ceyhunkocc/EE463-TermProject/Ceyhun/pcb screenshots/overview_new.JPG

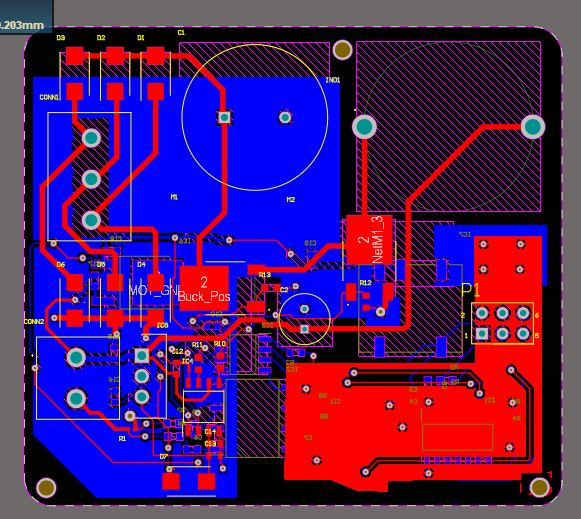
Ceyhun/pcb screenshots/overview_new.JPG
