ceyhunkocc/EE463-TermProject/Ceyhun/pcb screenshots/pcb_line_validate.JPG

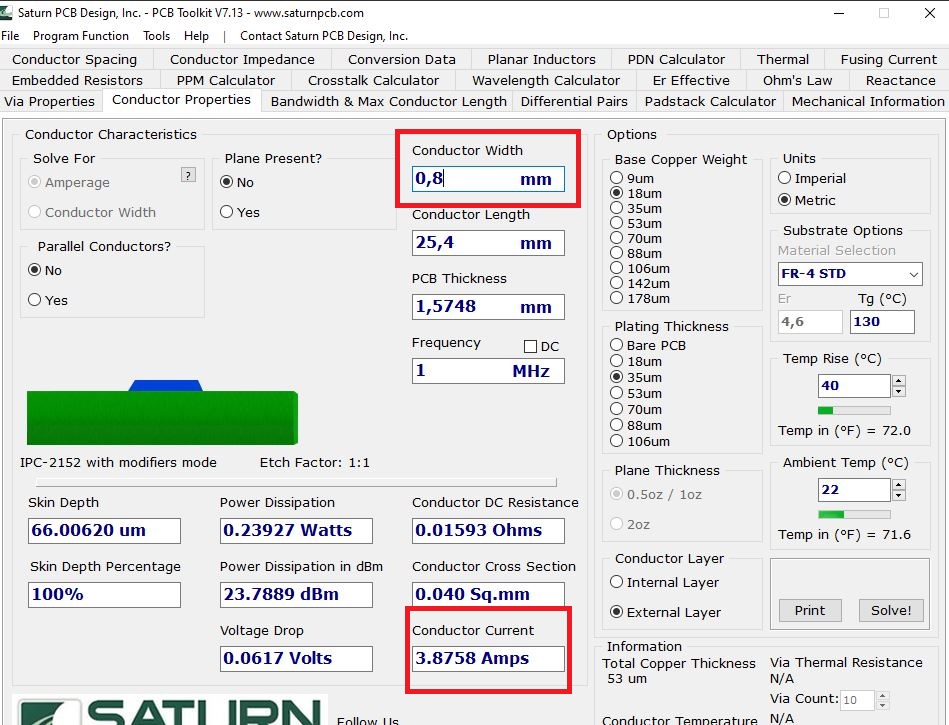
Ceyhun/pcb screenshots/pcb_line_validate.JPG
