ceyhunkocc/EE463-TermProject/README.md

# EE463-TermProject
This repository is used for term project works by Ceyhun KOÇ, Görkem GÜLLETUTAN and Defnenur KORKMAZ.
