ceyhunkocc/EE463-TermProject/Defne/simulation waveforms.docx

İnput output voltage rectifier


Phase a input and output current


Diode voltage and current


Buck mosfet voltage current


Buck output voltage current

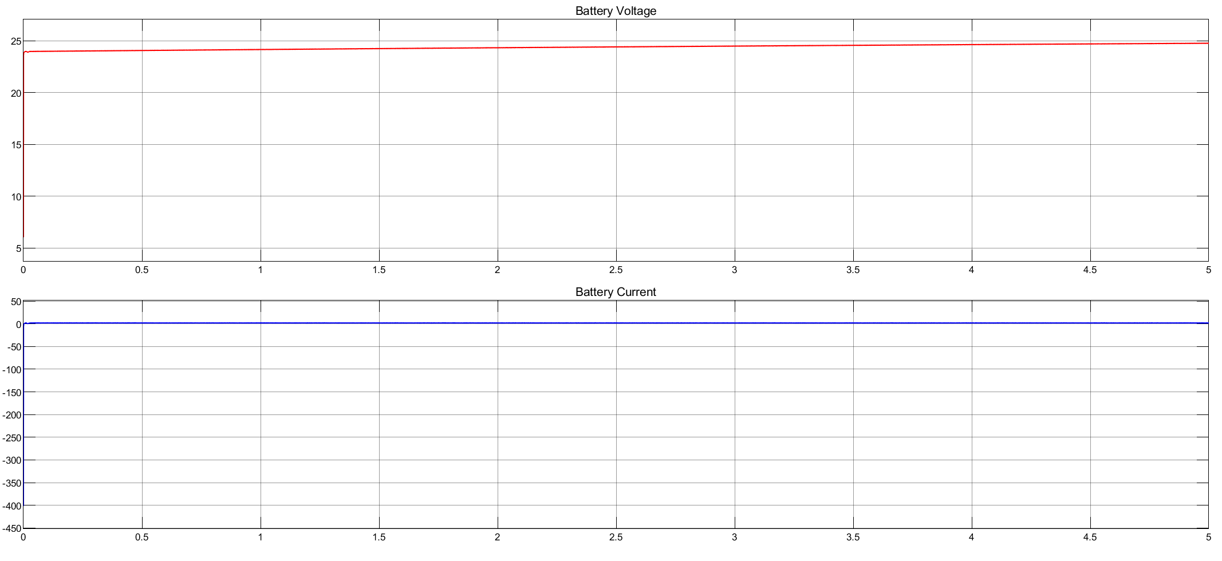
[picture p63: figure]
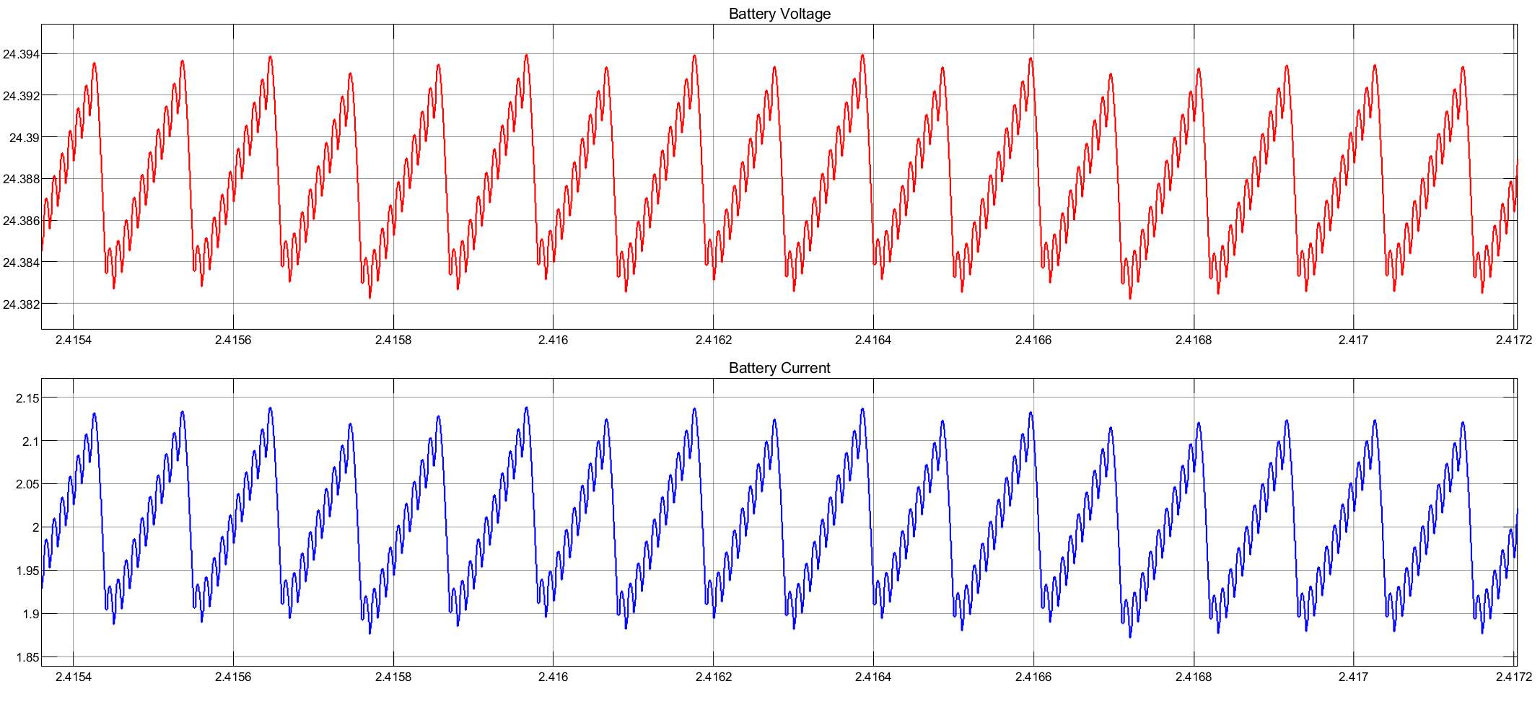
[picture p64: figure]

Battery current and voltage
