ceyhunkocc/EE463-TermProject/Ceyhun/pcb screenshots/Yeni Microsoft PowerPoint Presentation.pptx

Rectifier Capacitor

Buck Inductor


High Side Diodes

Motor Connector

Low Side Diodes

Battery Connector

Shunt Resistor

MOSFET High

Buck Capacitor

MOSFET Low

## Slide 2

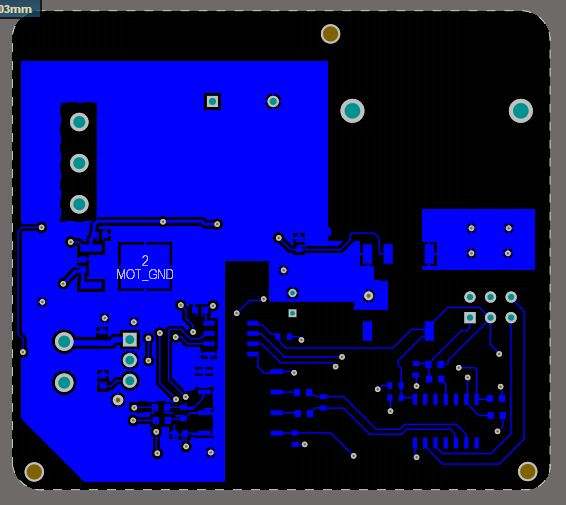
[picture p65: figure]

MOT_GND Plane

ISOLATION BOUNDARY

ISO_GND Plane

Digital Isolator

Controller Connector

Microcontroller

Isolated Op-amp

## Slide 3

24V/3V3 Conversion

24V/12V Conversion

3V3 Isolated Conversion

## Slide 4

Fiducial

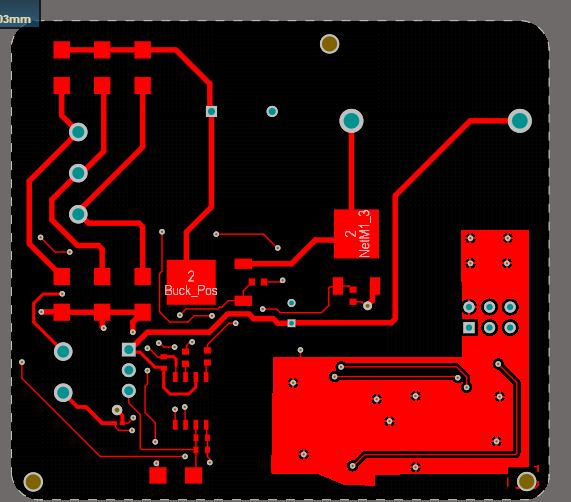
[picture p66: figure]

Gate Driver

Fiducial

Bootstrap Diode

Fiducial

## Slide 5

Rectifier Capacitor

Buck Inductor

High Side Diodes


Motor Connector

MOSFET Low w/heatsink

Low Side Diodes

Controller Connector

Battery Connector

Gate Driver

MOSFET High w/heatsink

24V/12V Conversion

Bootstrap Diode

Buck Capacitor

## Slide 6


24V/3V3 Conversion

Digital Isolator

Isolated Op-amp

3V3 Isolated Conversion

Microcontroller
