ceyhunkocc/EE463-TermProject/Defne/Inductor design/E.docx

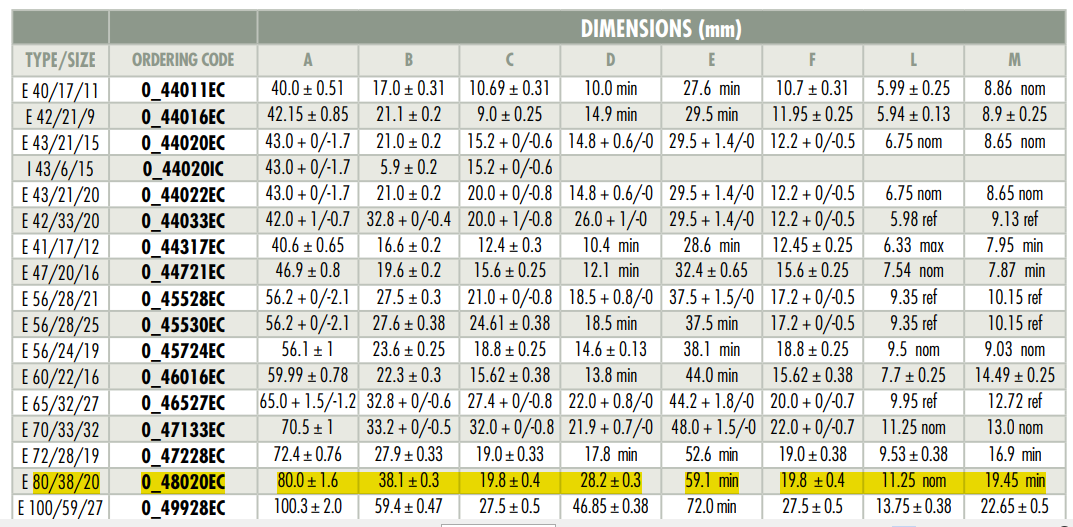
[picture p86: figure]
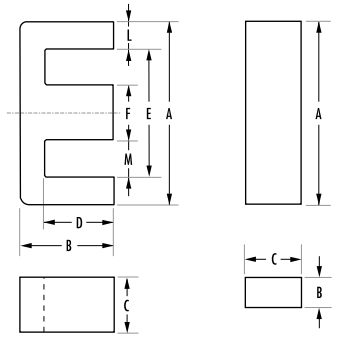
[picture p87: figure]

E, I cores

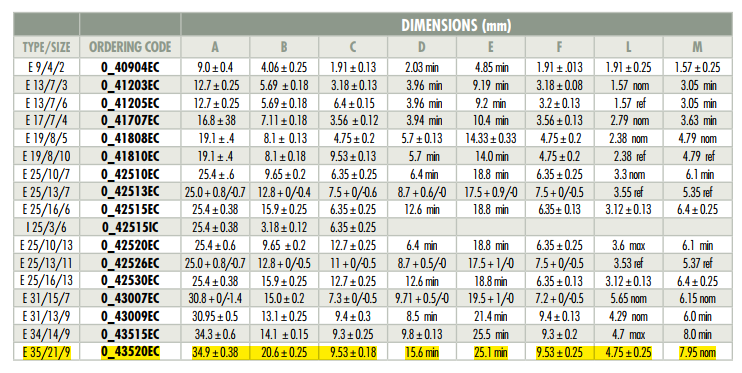
[picture p88: figure]
