ceyhunkocc/EE463-TermProject/Defne/Inductor design/1608928195178.pdf

Bobin Tasarımı

Tablodan Uygun Nüvenin Seçilmesi

Anahtarlamalı güç kaynaklarında kullanılan bobinler ve flyback dönüştürücülerde kullanılan transformatörler manyetik enerji depo eder. Bu enerji ferit nüvede büyük ölçüde hava aralığında depo edilir. Depo edilen enerji aşağıdaki şekilde hesaplanır.

Uygun bir nüve seçebilmek için;

- Nüvenin manyetik enerji depo etme kapasitesi hesaplanan ½ ·L I

2
max değerinden büyük
olmalıdır.
- Nüve boyutu mümkün olduğu kadar küçük olmalıdır.

Bobin için uygun bir nüvenin seçilmesinde kullanılacak olan tablo 11 sütundan oluşmaktadır. Flyback transformatörü için olan tabloda ise 12 sütun mevcuttur.

İlk dört sütunda nüve kodu ve üreticisi ile ilgili bilgiler verilmektedir.

1. Nüvenin kodu
2. Nüvenin türü
3. Karakteristik değerleri, hava aralığı, sipariş kodu v.b.
4. Üretici

5-8. sütunlarda katalog bilgileri verilmiştir. Bu bilgiler hesaplamalarda kullanılır.

5. AL/nH: Belirli bir L değeri için sarım sayısının ne olması gerektiği bu parametre kullanılarak bulunur.
6. Ae/mm²
: Nüvenin efektif kesiti.
7. le/mm: Nüvenin efektif uzunluğu
8. Amin/mm²
: Maksimum manyetik alan yoğunluğunun hesaplanması için kullanılan minimum kesit değeri

9-12. sütunlarda verilen bilgiler hesaplanarak elde edilir.

9. Wmax/mWs: Nüvenin manyetik enerji depo etme kapasitesi maksimum 0.3 T.
10. Bmax/mT: Nüvedeki maksimum akı yoğunluğu. Giriş gerilimi, nominal yük akımı ve minimum kesit Amin kullanılarak hesaplanan maksimum akı yoğunluğu nüve seçiminde dikkate alınır. Bmax değeri L veya ΔIL ‘ye bağlı olarak değişir.
11. N1 : L endüktansı için gerekli olan sarım sayısı.
12. N2 : Flyback dönüştürücüde sekonder sarım sayısı. N1/N2 oranı azalırsa transistörün Vds_max gerilimi azalır.

İyi seçilmiş bir nüvenin Wmax manyetik enerji depolama kapasitesi gerekli değerden biraz fazladır. Nüve mümkün olan en küçük nüvedir. Maksimum akı yoğunluğu doyma noktası olan 0.3T değerine yakındır.

Tel çapı akım yoğunluğu 3A/mm²
olacak şekilde seçilir.

Transformatör ve Bobin Hesabı

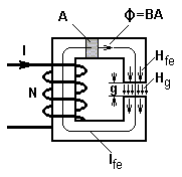
[picture p89: figure]

Ferit nüvede depo edilen manyetik enerjinin bir kısmı nüvede bir kısmı ise hava aralığında depo edilir. Nüvenin fiziksel boyutu depo edilen enerji ile orantılıdır.

Depo edilen manyetik enerji aşağıki eşitlikle verilir.

Manyetik akı yoğunluğu B sürekli olup hava aralığında ve nüve içinde aynıdır.

B ≈ BFe ≈ Bg

Manyetik alan kuvveti H ise sürekli değildir. Hava aralığındaki manyetik alan kuvveti ferit nüve içindeki kuvvetin μr katıdır.

B = μ0μr ·H
IFe = lFe ·A
Vg = g ·A:

g .A

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
Ferit malzemede μr değeri 1000...4000 arasındadır. Effektif manyetik nüve uzunluğu enerji hesabına lFe / μr oranı ile katılır. Normal bir nüvede manyetik enerji büyük ölçüde hava aralığında depo edilir. Bunun sonucu olarak bobin hava aralıklı nüve kullanılarak yapılır. Bmax = 0.3T’yı geçmeyecek şekilde yeterli enerji depo edebilmesi için ne kadar bir hava aralığının bırakılması gerektiği hesaplanır.

Hava aralığı arttıkça manyetik enerji depo etme kapasitesi artar.
Ferit nüve üreticileri (lFe/μr+g)·A) terimini kapsayan değerler verir. Bu değerler,

- Nüvenin efektif manyetik kesiti Ae,
- Nüvenin efektif manyetik yolu le
- Nüvenin efektif permeabilitesi μe.

Bu değerler bağlı olarak

e

e
e
r
Fe | l
g .A | A .

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
μe değeri manyetik iletkenlik AL kullanılarak hesaplanır.

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
e L A

l
A .

Manyetik enerji depo etme kapasitesi aşağıdaki şekilde hesaplanır.

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
B 0.3T

Tabloda verilen Ae, le, AL ve Amin değerleri kullanılarak manyetik enerji depo etme kapasitesi hesaplanır. Bu sonuca uygun olan nüveler arasından seçim yapılır. Seçilen nüvenin Wmax değeri W = ½ L I

2
değerinden büyük olmalıdır. Nüve hacmi Ae·le ile hesaplanır.

N1 sarım sayısı manyetik iletkenlik AL kullanılarak hesaplanır.

Flyback dönüştürücüde sekonder sarım sayısı dönüştürme oranı ve N1 kullanılarak aşağıdaki şekilde hesaplanır.

Tel Çapının Hesaplanması

S akım yoğunluğu transformatörün termik direncine bağlı olarak 2 ile 5 A/mm² arasında
seçilir. Tel kesiti ve yarıçapı aşağıdaki şekilde hesaplanır.
