ceyhunkocc/EE463-TermProject/Gorkem/powerlosses.thermalanalysis.pdf

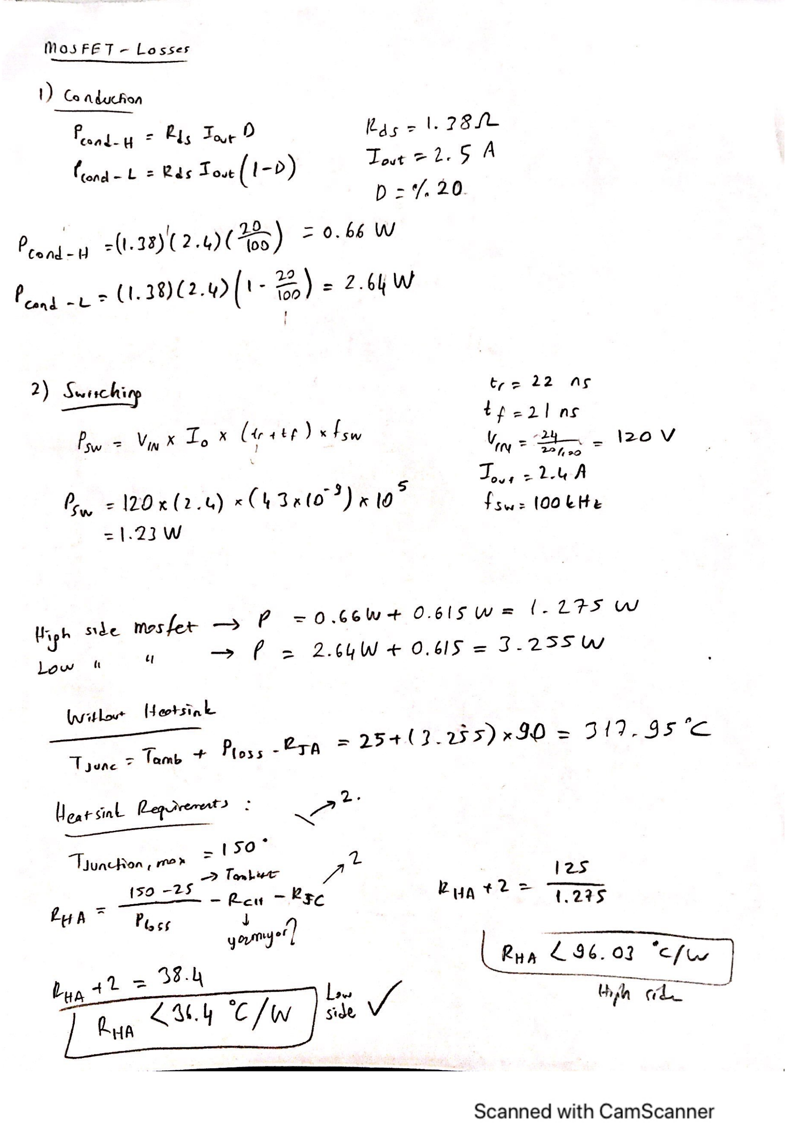
[picture p90: page 1]
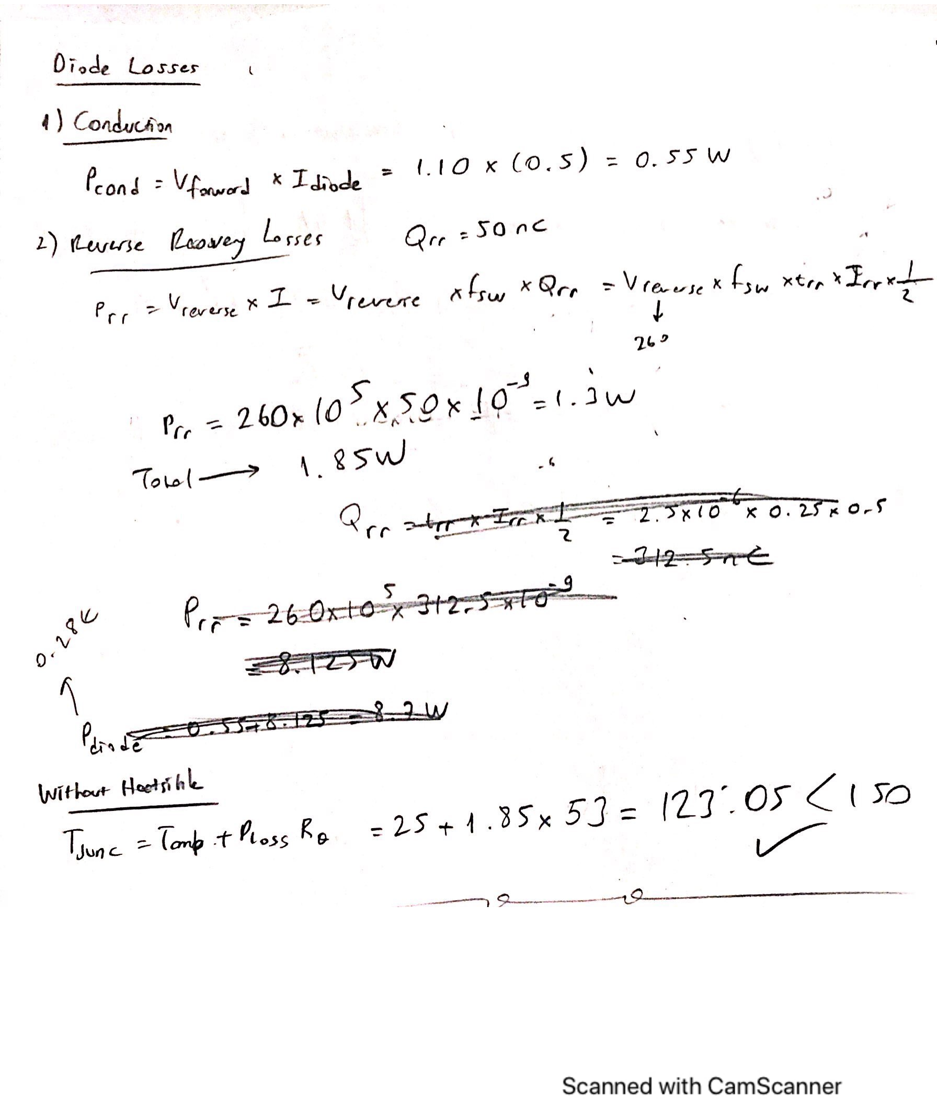
[picture p91: page 2]
