ceyhunkocc/EE463-TermProject/Defne/Inductor design/1608928195184.xls

 | http://www.cosmoferrites.com/product/eeindex2.html#
TYPE | DIMENSIONS (mm) |  |  |  |  |  | AL (nH) +30%
 |  |  |  |  |  |  | -20%
 | A | B | C | D | E | F |  | CF 196 (http://www.cosmoferrites.com/material_info.html) | CF 138 (http://www.cosmoferrites.com/material_info.html) | CF101 (http://www.cosmoferrites.com/material_info.html) | CF195 (http://www.cosmoferrites.com/material_info.html)
EE10028 | 100.3±2.0 | 73.2±1.40 | 59.5±0.50 | 46.8±0.80 | 27.5±0.50 | 27.6±0.50 |  | 5900 | 6200 | - | -
EE8020 | 80.00 -0.90 | 60.30+0.90 | 38.10+0.33 | 28.53 +0.33 | 19.80 -0.30 | 19.80 -0.30 |  | 4500 | 4700 | -- | --
EE7219 | 72.40 -1.45 | 53.35+1.10 | 27.95+0.15 | 18.05 +0.25 | 19.05 -0.38 | 19.05 -0.38 |  | 6200 | 6500 | 8900 | --
EE6527 | 66.50 -2.70 | 44.20+1.80 | 32.50+0.30 | 22.20 +0.70 | 20.00 -0.70 | 27.40 -0.80 |  | 7800 | 8100 | -- | --
EE6513 | 66.50 -2.70 | 44.20+1.80 | 32.50+0.30 | 22.20 +0.70 | 20.00 -0.70 | 13.70 -0.60 |  | 3900 | 4050 | 5400 | --
EE5541 | 55.1±1.1 | 38.1±0.75 | 27.5±0.15 | 18.8±0.4 | 16.85±0.3 | 40.9±0.75 |  | 12200 | 12750 | - | -
EE5525 | 55.00+1.20 | 37.50+1.20 | 27.80-0.60 | 18.50 +0.80 | 17.20 -0.50 | 25.00 -0.60 |  | 7600 | 7950 | -- | --
EE5521 | 55.00+1.20 | 37.50+1.20 | 27.80-0.60 | 18.50 +0.80 | 17.20 -0.50 | 21.00 -0.60 |  | 6200 | 6400 | 8700 | --
EE4732 | 46.85±1.0 | 32.25±0.7 | 19.6±0.2 | 12.2±0.3 | 15.6±0.3 | 31.25±0.3 |  | 11400 | 11900 | 15650 | -
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
EEL1905 | 19.00 +0.30 | 14.00+0.30 | 13.55+0.20 | 11.30 +0.30 | 4.85 +0.25 | 4.85 +0.20 |  | 800 | 850 | 1100 | 1550
EEL1605 | 16.00 +0.30 | 12.10 +0.30 | 12.45 +0.20 | 10.25 +0.20 | 4.00 -0.20 | 4.80 -0.20 |  | 700 | 750 | 950 | 1350
EEL1605B | 16.00 +0.70 | 12.10 +0.30 | 6.95 +0.15 | 5.40 +0.20 | 4.00 -0.20 | 4.80 -0.20 |  | 875 | 900 | 1150 | 1550
