ceyhunkocc/EE463-TermProject/Ceyhun/battery_new.jpg

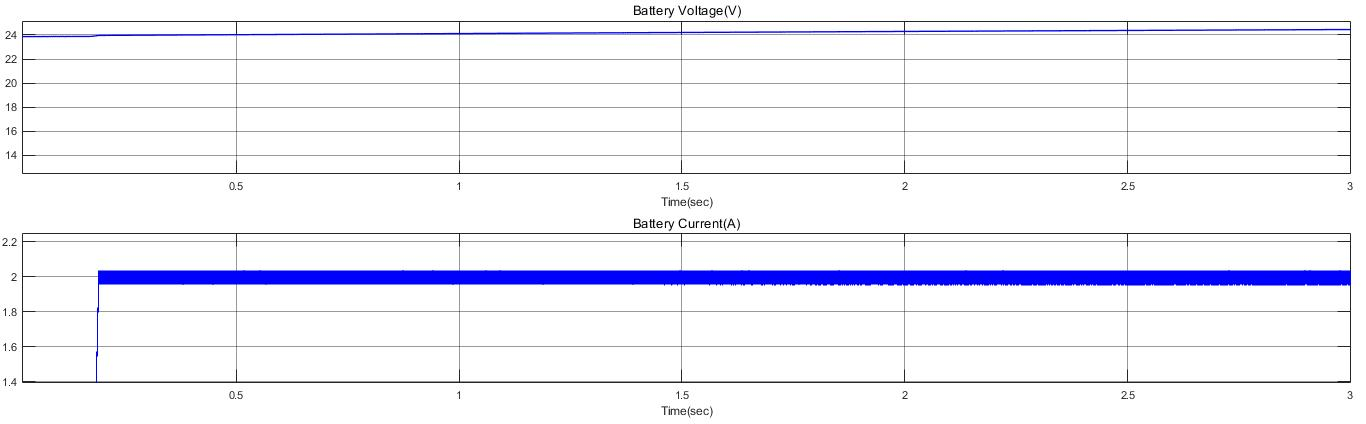
Ceyhun/battery_new.jpg
