ceyhunkocc/EE463-TermProject/Ceyhun/battery_new_detailled.jpg

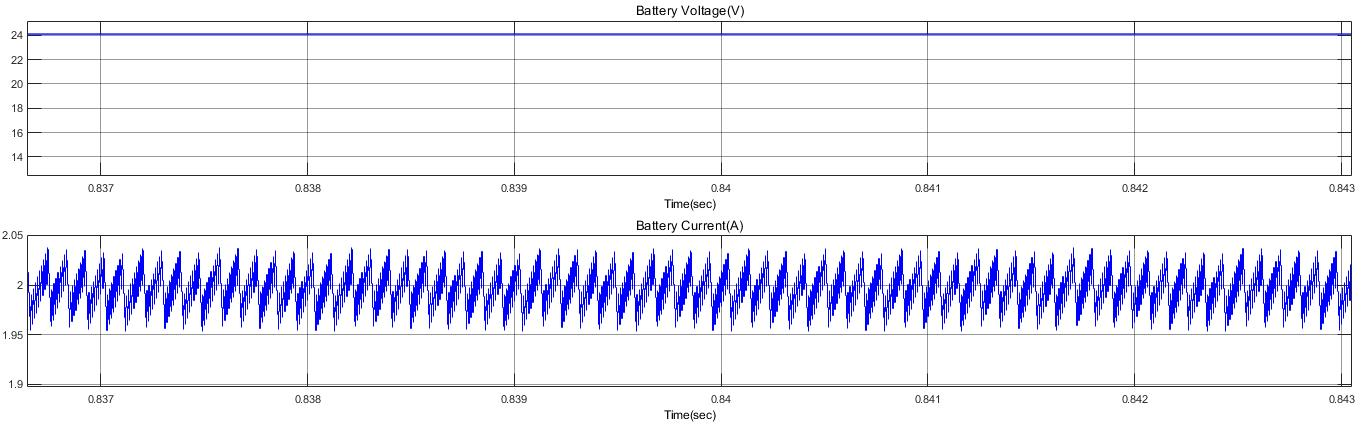
Ceyhun/battery_new_detailled.jpg
