ceyhunkocc/EE463-TermProject/Ceyhun/Ideal Simulations/battery output.jpg

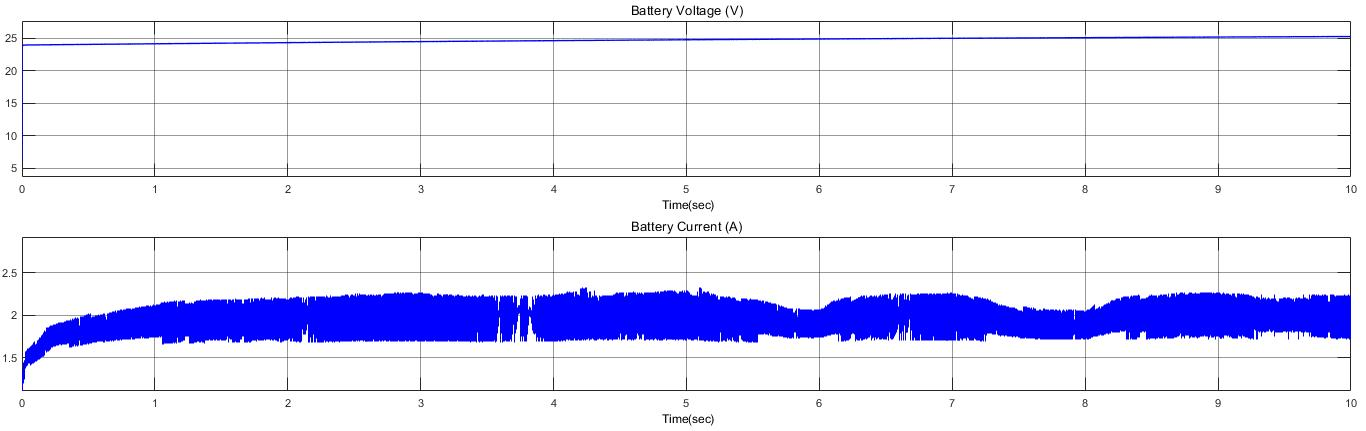
Ceyhun/Ideal Simulations/battery output.jpg
