ceyhunkocc/EE463-TermProject/Ceyhun/Ideal Simulations/duty cycle.jpg

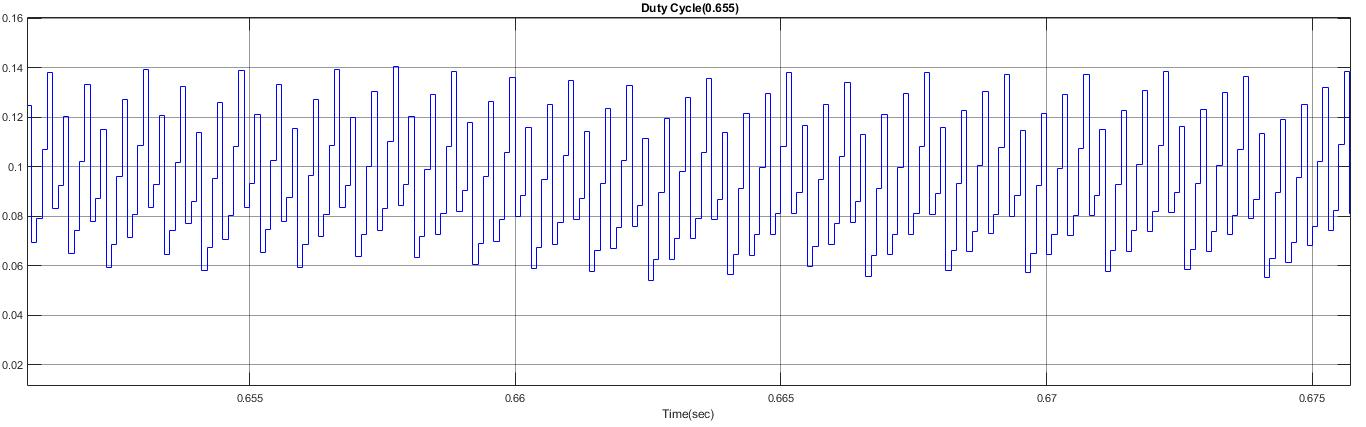
Ceyhun/Ideal Simulations/duty cycle.jpg
