ceyhunkocc/EE463-TermProject/Ceyhun/Ideal Simulations/Input l-l.jpg

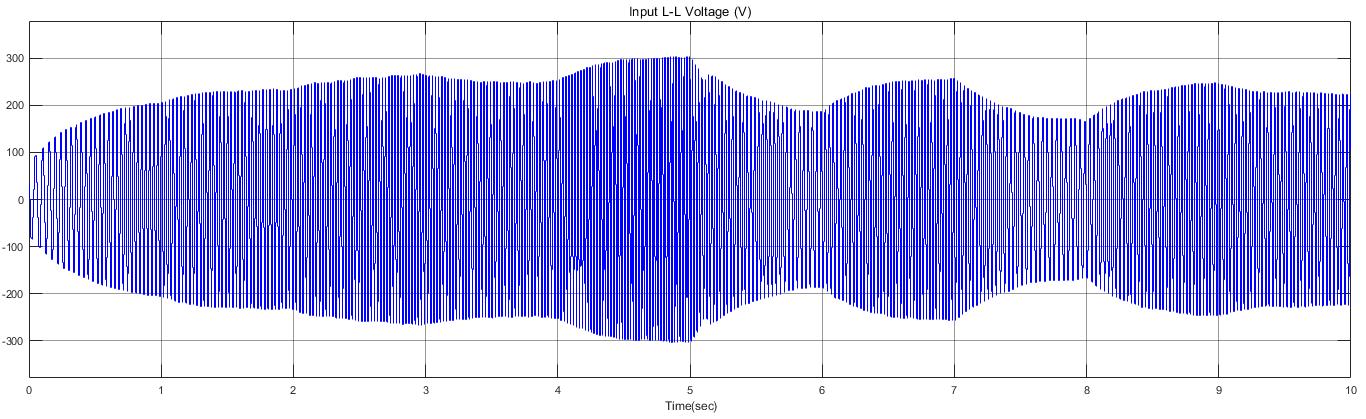
Ceyhun/Ideal Simulations/Input l-l.jpg
