ceyhunkocc/EE463-TermProject/Ceyhun/Nonideal Simulations/Battery output.jpg

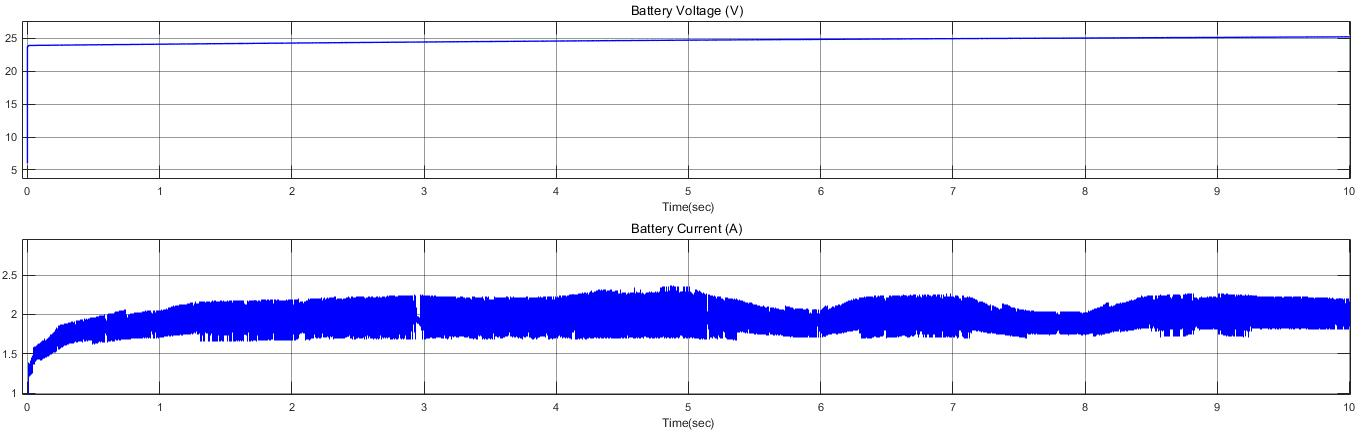
Ceyhun/Nonideal Simulations/Battery output.jpg
