ceyhunkocc/EE463-TermProject/Ceyhun/Nonideal Simulations/duty cycle.jpg

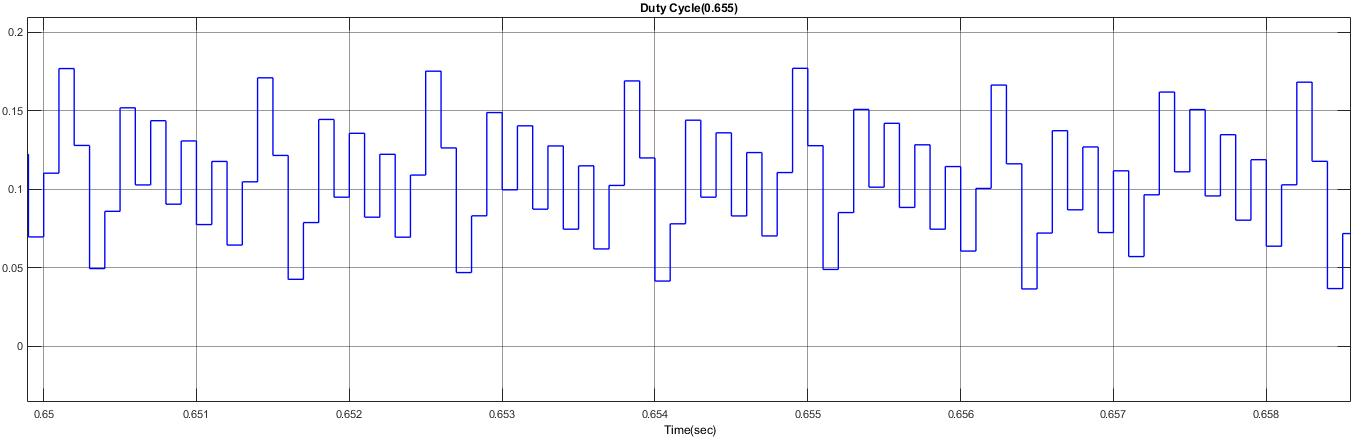
Ceyhun/Nonideal Simulations/duty cycle.jpg
