ceyhunkocc/EE463-TermProject/Ceyhun/Nonideal Simulations/Rectifier Output.jpg

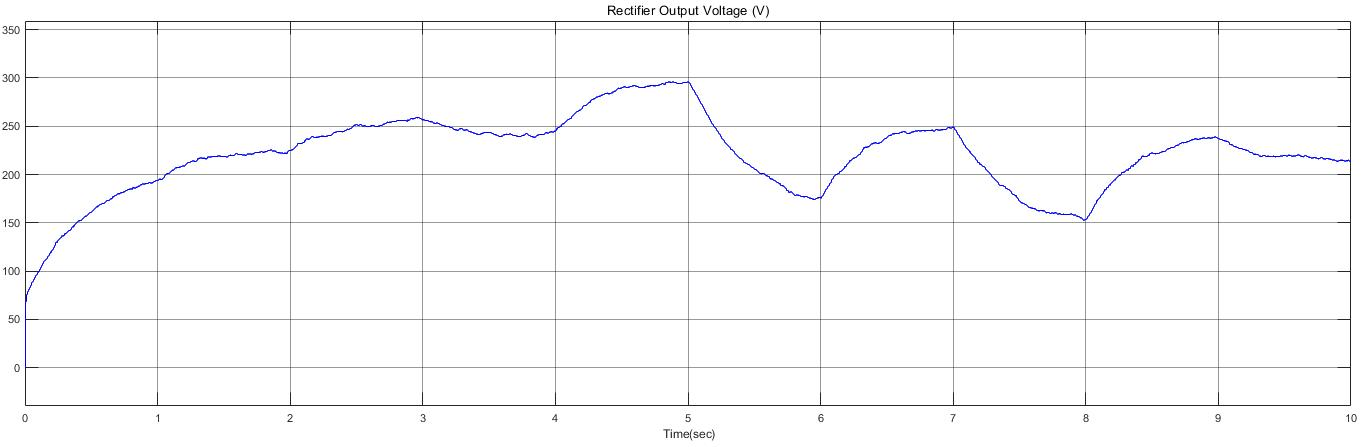
Ceyhun/Nonideal Simulations/Rectifier Output.jpg
