ceyhunkocc/EE463-TermProject/Ceyhun/pcb screenshots/pcb_power_line.JPG

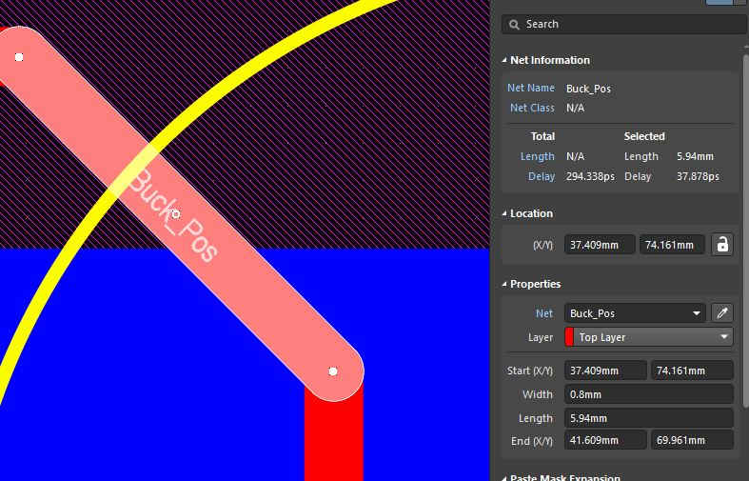
Ceyhun/pcb screenshots/pcb_power_line.JPG
