ceyhunkocc/EE463-TermProject/Ceyhun/pcb screenshots/pcb_power_via.JPG

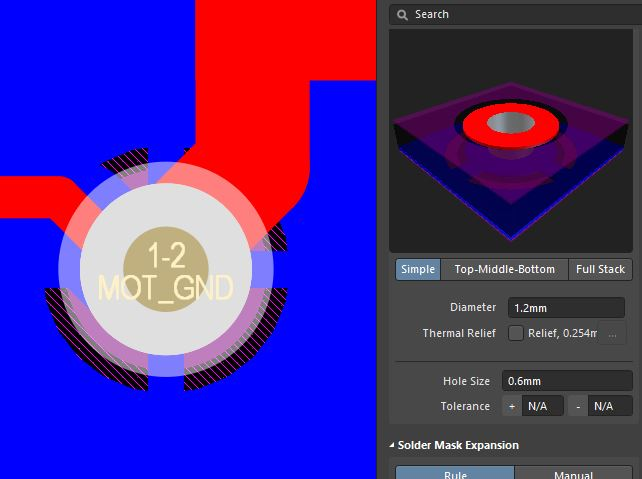
Ceyhun/pcb screenshots/pcb_power_via.JPG
