ceyhunkocc/EE463-TermProject/Ceyhun/pcb screenshots/rect-buck.JPG

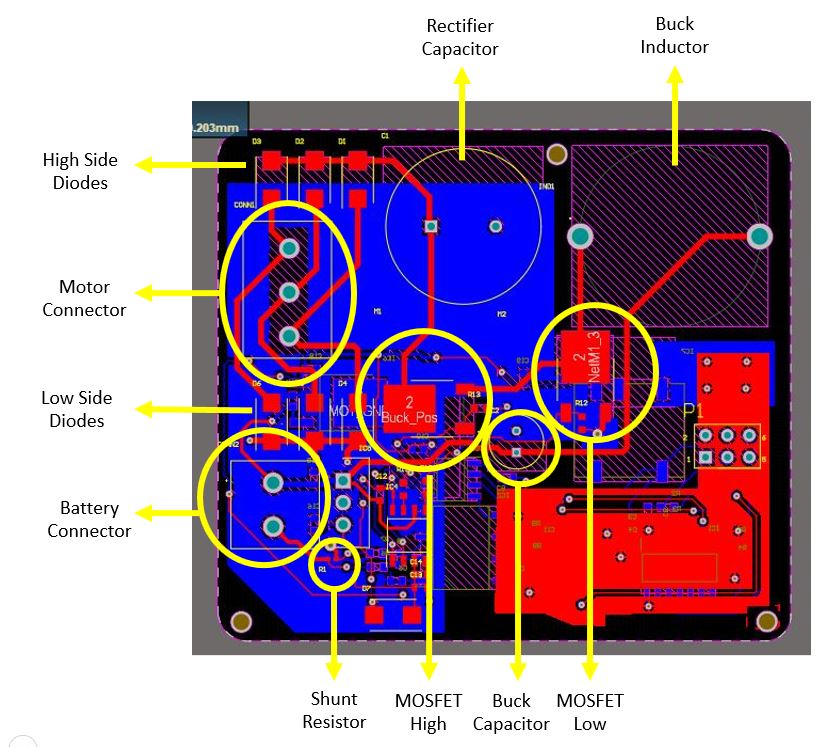
Ceyhun/pcb screenshots/rect-buck.JPG
