ceyhunkocc/EE463-TermProject/Ceyhun/WhatsApp Image 2020-12-22 at 00.09.55.jpeg

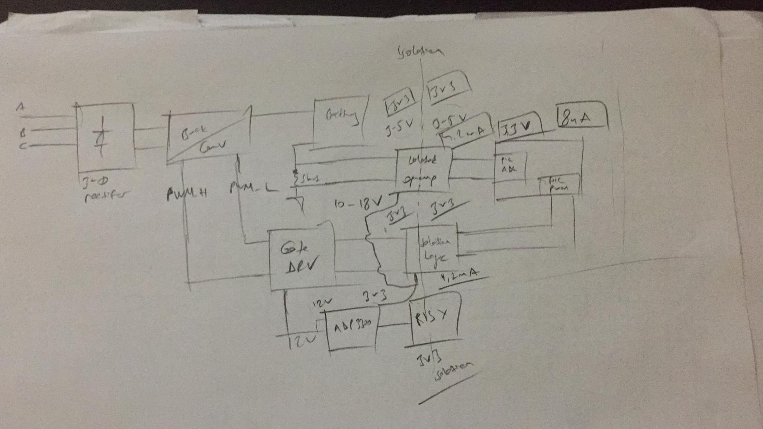
Ceyhun/WhatsApp Image 2020-12-22 at 00.09.55.jpeg
