ceyhunkocc/EE463-TermProject/Defne/Simulation Report/Output waveform.jpeg

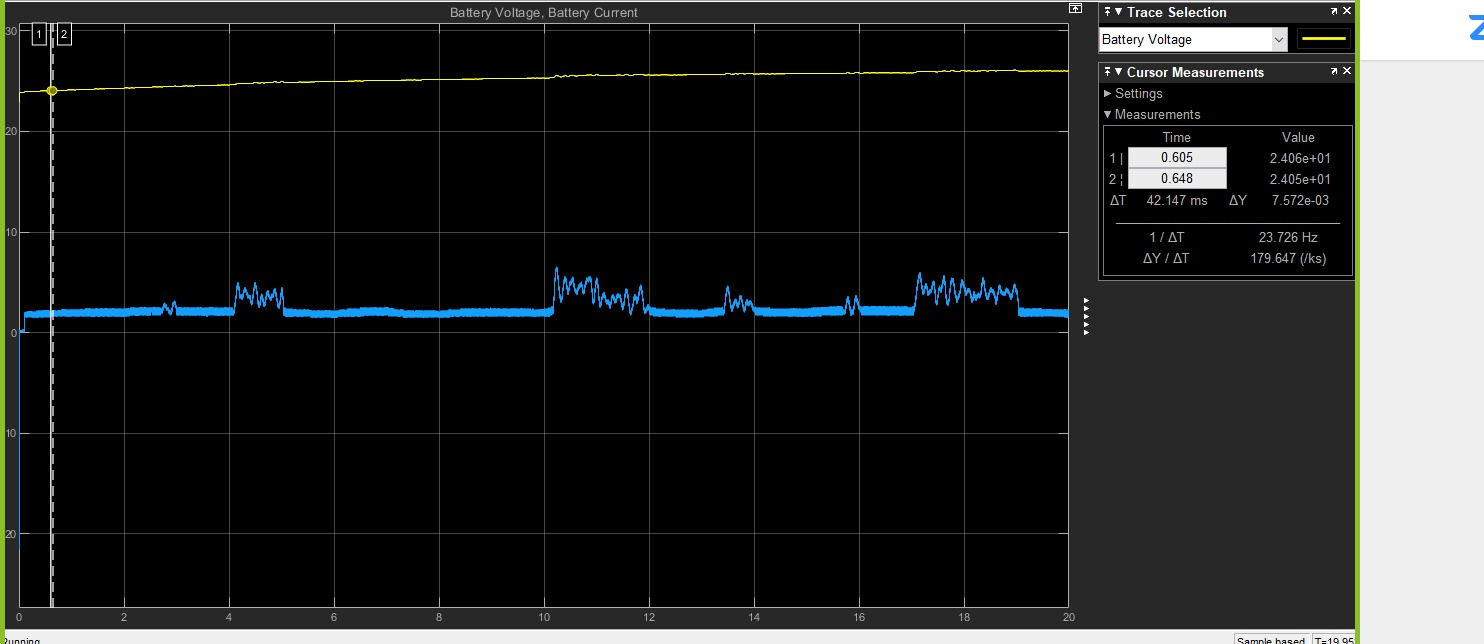
Defne/Simulation Report/Output waveform.jpeg
