ceyhunkocc/EE463-TermProject/Gorkem/Ideal Simulations/rectifier/rec_inputcurrent_thd.jpg

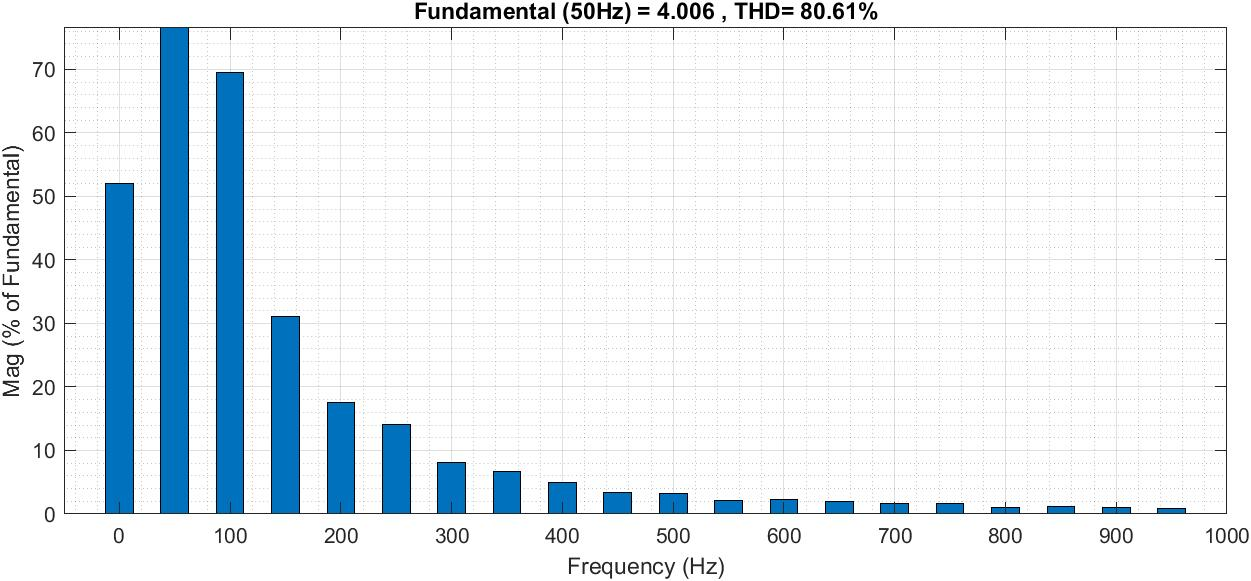
Gorkem/Ideal Simulations/rectifier/rec_inputcurrent_thd.jpg
