ceyhunkocc/EE463-TermProject/Gorkem/Ideal Simulations/rectifier/rec_outputcurrent_thd.jpg

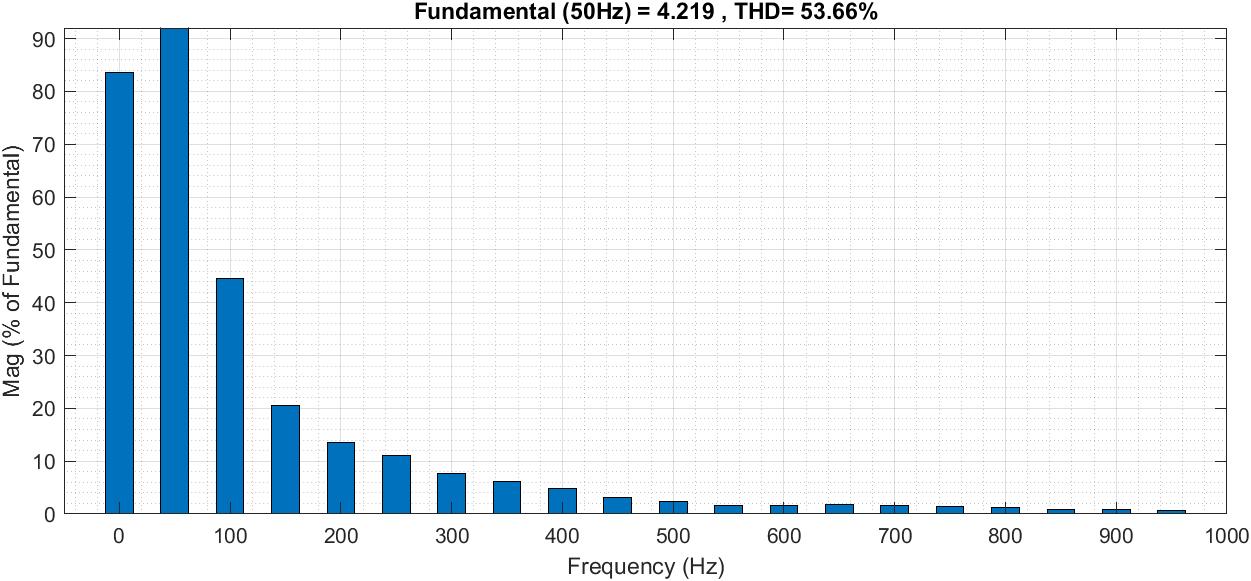
Gorkem/Ideal Simulations/rectifier/rec_outputcurrent_thd.jpg
