ceyhunkocc/EE463-TermProject/Gorkem/Ideal Simulations/rectifier/rectifier_input_output_current.jpg

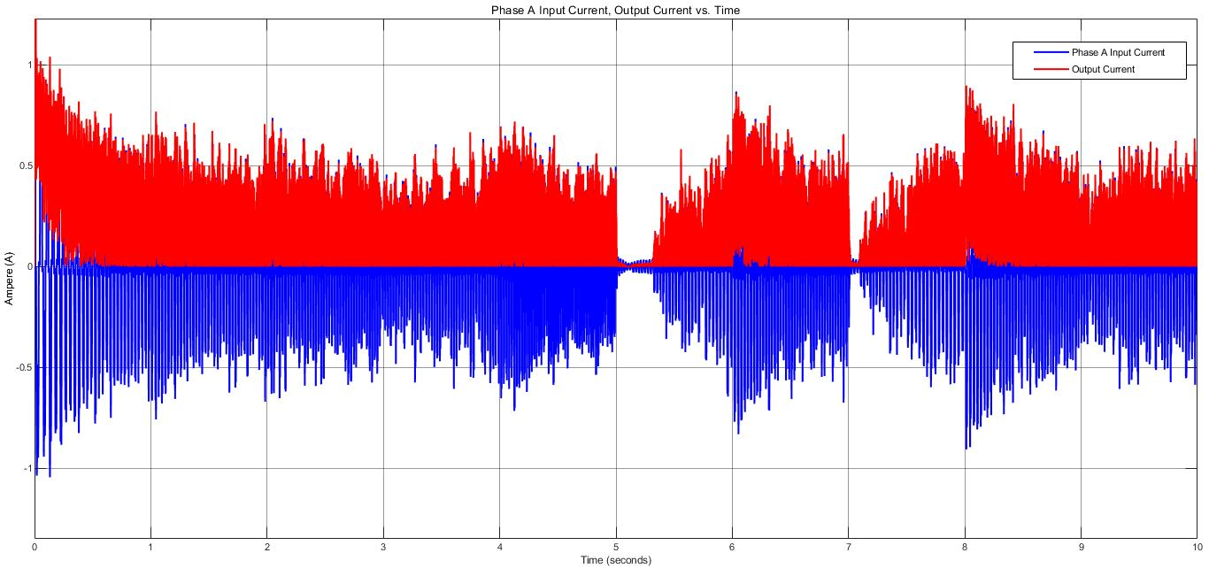
Gorkem/Ideal Simulations/rectifier/rectifier_input_output_current.jpg
