ceyhunkocc/EE463-TermProject/Gorkem/Ideal Simulations/rectifier/rectifier_outputcurrent.jpg

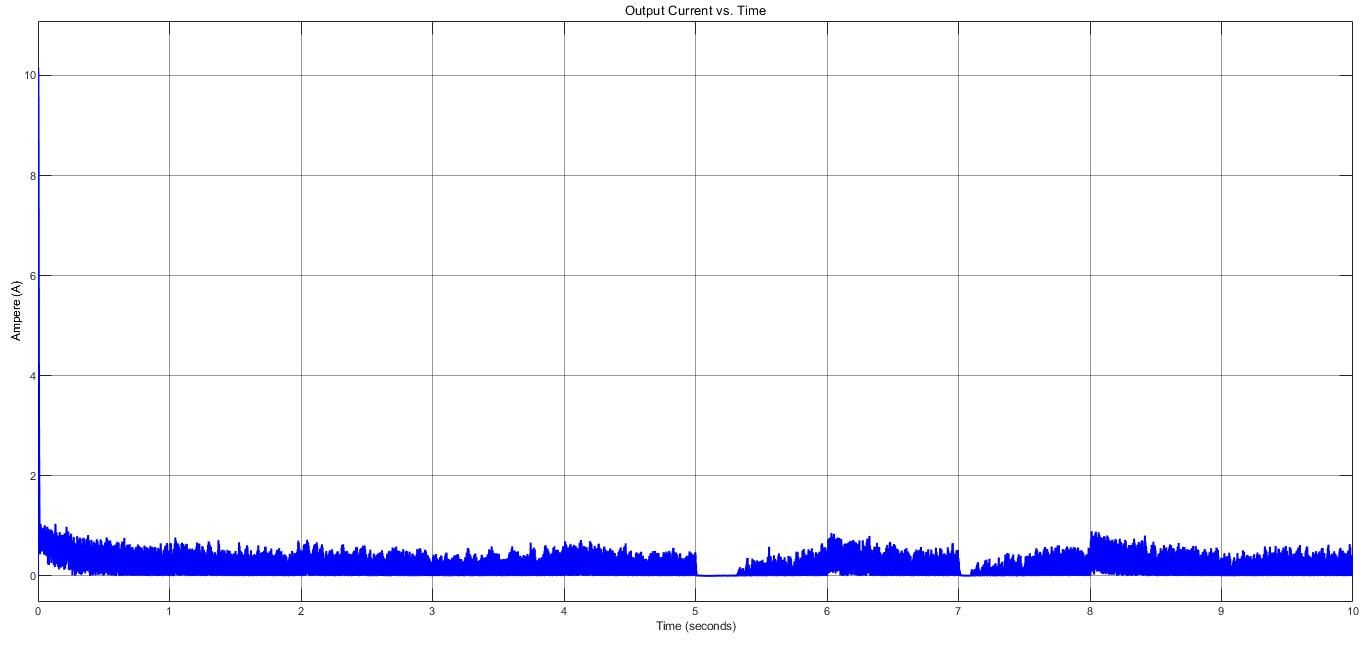
Gorkem/Ideal Simulations/rectifier/rectifier_outputcurrent.jpg
