ceyhunkocc/EE463-TermProject/Gorkem/Ideal Simulations/rectifier/threephasedioderec_schematic.jpg

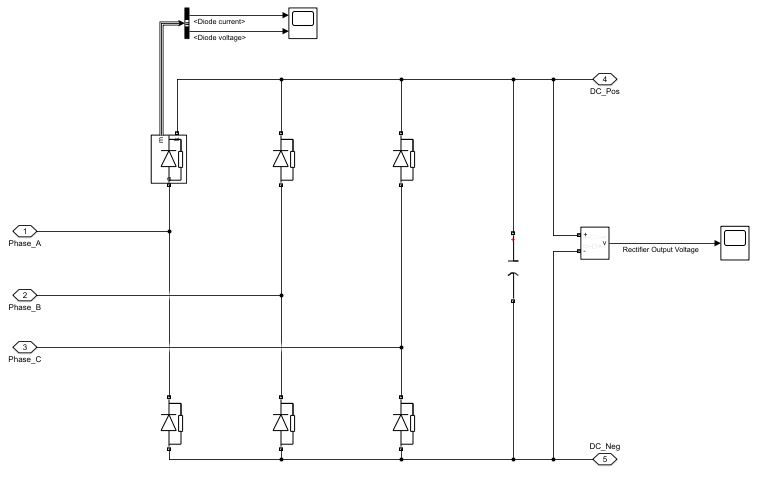
Gorkem/Ideal Simulations/rectifier/threephasedioderec_schematic.jpg
