ceyhunkocc/EE463-TermProject/Defne/Component Selection Final.docx

1. Rectifier:
a. Diode

https://www.digikey.com/en/products/detail/on-semiconductor/S2G/1049006

b. Capacitor

https://www.digikey.com/en/products/detail/kemet/ESH107M450AN2AA/7423958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

2. Buck Converter
a. MOSFET

https://www.digikey.com/en/products/detail/on-semiconductor/FDD5N50NZTM/2509581

b. Heatsink

https://www.digikey.com/en/products/detail/assmann-wsw-components/V-1100-SMD-B/3511513

c. Inductor

https://www.digikey.com/en/products/detail/abracon-llc/AIRD-02-102K/2660716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

d. Capacitor

https://www.digikey.com/en/products/detail/w%C3%BCrth-elektronik/860020573008/5728885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

3. Gate Drive
a. Driver

https://www.digikey.com/en/products/detail/rohm-semiconductor/BS2103F-E2/5955649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

b. Bootstrap Diode

https://www.digikey.com/en/products/detail/on-semiconductor/S2G/1049006

4. Isolation
a. Isolated Opamp

https://www.digikey.com/en/products/detail/silicon-labs/SI8920BC-IP/5358956

b. Digital Isolator

https://www.digikey.com/en/products/detail/silicon-labs/SI8620AB-B-IS/4576730

c. Controller

https://www.digikey.com/en/products/detail/microchip-technology/PIC16F1614-E-SL/5050777

d. Shunt Resistor

https://www.digikey.com/en/products/detail/stackpole-electronics-inc/CSS0402FT10L0/10719366

5. Power Conversion
a. 24v/3V3

https://www.digikey.com/en/products/detail/texas-instruments/UA78M33CKVURG3/1216814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

b. 24v/12v

https://www.digikey.com/en/products/detail/texas-instruments/UA7812CKCS/521614

c. 3V3 Isolation

https://www.digikey.com/en/products/detail/recom-power/R1SX-3-33-3-R/6708872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

6. Connectors
a. Motor

https://www.digikey.com/en/products/detail/phoenix-contact/5452258/4391131?s=N4IgTCBcDaIKwBY5jHAHCAugXyA

b. Battery

https://www.digikey.com/en/products/detail/cui-devices/TB007-508-02BE/10064127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

c. ICSP

https://www.digikey.com/en/products/detail/adam-tech/PH2-06-UA/9830396

7. Capasitors
a. 10nF

https://www.digikey.com/en/products/detail/kemet/C0603C103M5RAC7411/12701322

b. 100nF

https://www.digikey.com/en/products/filter/ceramic-capacitors/60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

c. 1uF

https://www.digikey.com/en/products/detail/cal-chip-electronics-inc/GMC10X7R105K25NT/12324800

d. 0.33 uf

https://www.digikey.com/en/products/detail/würth-elektronik/885012206074/5453847

e. 22uF
8. Resistors
a. 20ohm

https://www.digikey.com/en/products/detail/RK73B1JTTD200G/2019-RK73B1JTTD200GCT-ND/12356499?itemSeq=350638944

b. 4.7K

https://www.digikey.com/en/products/detail/RK73B1JRTTD472G/2019-RK73B1JRTTD472GCT-ND/12358871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

c. 1k

https://www.digikey.com/en/products/detail/würth-elektronik/885012206074/5453847

d. 10k

https://www.digikey.com/en/products/detail/RK73B1JTTD103G/2019-RK73B1JTTD103GCT-ND/12354711?itemSeq=350640624

e. 5.6k

https://www.digikey.com/en/products/detail/RK73B1JTTD562G/2019-RK73B1JTTD562GCT-ND/12358993?itemSeq=350641383
