ceyhunkocc/EE463-TermProject/Ceyhun/Component Selection/Component Selection.docx

1. Rectifier
  a. Diode: Reverse Voltage 300V min. Current 1A Avg, 10A surge

https://www.digikey.com/en/products/detail/smc-diode-solutions/FR2GTA/5993216

https://www.bourns.com/docs/Product-Datasheets/CD214B-R250_R21000.pdf

https://www.digikey.com/en/products/detail/smc-diode-solutions/S2GTR/6022599

last

  b. Capacitor: 300V (1mF)

https://www.digikey.com/en/products/detail/kemet/ALF20G102EJ450/8681391

https://www.digikey.com/en/products/detail/kemet/ALF20G102EP500/8681394

https://www.mouser.com.tr/ProductDetail/United-Chemi-Con/EKXL401ELL101MM25S/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

2. Buck Converter
  a. Mosfet: 300V blocking, 2A cont. Current min.

https://www.onsemi.com/products/discretes-drivers/mosfets/fdd5n50nz

(high)

https://www.mouser.com.tr/ProductDetail/ON-Semiconductor-Fairchild/FDD5N50NZTM/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

(low)

(same mosfet both, we can discard diode below, use mouser link)

  b. Inductor: 300V, 2A min.

https://www.mouser.com.tr/ProductDetail/EPCOS-TDK/B82615B2202M001/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

https://www.mouser.com.tr/ProductDetail/ABRACON/AIRD-02-102K/?qs=qV1JnYL3zOwesCnq0b0JTA%3D%3D

  c. Diode: 300V, 2A min.

https://www.digikey.com/en/products/detail/taiwan-semiconductor-corporation/S4G-V6G/8017559

https://www.digikey.com/en/products/detail/taiwan-semiconductor-corporation/S4G-R7G/7358511

LAST

Bootstrap diode:

https://www.mouser.com.tr/ProductDetail/Vishay-Semiconductors/VS-10BQ030-M3-5BT/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

  d. Capacitor: 25V

https://www.digikey.com/en/products/detail/nichicon/UVK1V102MHD/2539435

https://www.digikey.com/en/products/detail/illinois-capacitor/108RZM035M1325/5410896

(2nd one)

https://www.mouser.com.tr/ProductDetail/Wurth-Elektronik/860020572003/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

https://www.mouser.com.tr/ProductDetail/Wurth-Elektronik/860020573008/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

  e. Shunt Resistor:

https://www.digikey.com/en/products/detail/stackpole-electronics-inc/CSS0402FT10L0/10719366

  f. Controller

https://www.microchip.com/wwwproducts/en/PIC16F1613

  g. Isolated Opamp

https://www.mouser.com.tr/ProductDetail/Silicon-Labs/SI8920BC-IP/?qs=bB7QTEcmLuN2VIVidYwh9w%3D%3D

  h. Gate Driver

https://www.mouser.com.tr/ProductDetail/Infineon-Technologies/2ED2182S06FXUMA1/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

https://www.mouser.com.tr/ProductDetail/ROHM-Semiconductor/BS2103F-E2/?qs=iaprbs8w3G9rav1d9DTYOA%3D%3D

first one dead time adjustable, second one cheap

  i. 12V/3V3 (300mA) Regulator

https://www.mouser.com.tr/ProductDetail/Diodes-Incorporated/AP2210K-33TRG1/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

  j. 24V/3V3 (1A) Regulator

https://www.mouser.com.tr/ProductDetail/ROHM-Semiconductor/BA033CC0FP-E2/?qs=4kLU8WoGk0vZtk7EcED04A%3D%3D

  k. 24v/3v3 (500ma) Regulator

https://www.mouser.com.tr/ProductDetail/Texas-Instruments/UA78M33CKVURG3/?qs=0O%2FZFlpUpJXrDg4gfD1Q2g%3D%3D

  l. 24V/12V (1.5A) Regulator

mouser.com.tr/ProductDetail/Texas-Instruments/UA7812CKCS/?qs=DcvZ7Fltd5zyvhYGYzcR7A%3D%3D

  m. 3V3/3V3 Isolated (300mA) Converter

https://www.mouser.com.tr/ProductDetail/RECOM-Power/R1SX-3333-R/?qs=AQlKX63v8Rsf1yduGKaK6w%3D%3D

  n. Isolation Logic

https://www.mouser.com.tr/ProductDetail/Silicon-Labs/SI8620AB-B-ISR/?qs=j6MGy4L9yX20sFXZc1kgqQ%3D%3D

  o. Connectors

Battery:

https://www.mouser.com.tr/ProductDetail/CUI-Devices/TB007-508-02BE/?qs=vLWxofP3U2y6PFKAfCqKUQ%3D%3D

motor:

https://www.mouser.com.tr/ProductDetail/Phoenix-Contact/5452258/?qs=iCzJi%2FIZBF77ZcTXZHmYbQ%3D%3D

ıcsp:

https://www.mouser.com.tr/ProductDetail/Amphenol-FCI/67997-100HLF/?qs=cpLrBgdhsoH33Mp6xh%2FbyQ%3D%3D
