ceyhunkocc/EE463-TermProject/Defne/Cost/2021-01-15T045232.xlsx

Index | Quantity | Part Number | Manufacturer Part Number | Description | Customer Reference | Available | Backorder | Unit Price | Extended Price USD
1 | 1000 | 399-15674-ND | ESH107M450AN2AA | CAP ALUM 100UF 20% 450V T/H |  | 1000 | 0 | 1.15072 | 1150.72
2 | 1000 | 732-8942-1-ND | 860020573008 | CAP ALUM 100UF 20% 35V RADIAL |  | 1000 | 0 | 0.08 | 80.00
3 | 2000 | FDD5N50NZTMCT-ND | FDD5N50NZTM | MOSFET N-CH 500 4A DPAK |  | 1637 | 363 | 0.396 | 792.00
4 | 1000 | 535-11423-ND | AIRD-02-102K | FIXED IND 1MH 1A 818 MOHM TH |  | 414 | 586 | 1.8432 | 1843.20
5 | 1000 | BS2103F-E2CT-ND | BS2103F-E2 | IC GATE DRVR HALF-BRIDGE 8SOP |  | 74 | 926 | 0.42 | 420.00
6 | 1000 | 336-3329-5-ND | SI8920BC-IP | IC ISOLATION 8DIP GULL WING |  | 872 | 128 | 2.65551 | 2655.51
7 | 6000 | S2GFSTR-ND | S2G | DIODE GEN PURP 400V 2A DO214AA |  | 0 | 6000 | 0.05698 | 341.88
8 | 1000 | S2GFSCT-ND | S2G | DIODE GEN PURP 400V 2A DO214AA |  | 811 | 189 | 0.07084 | 70.84
9 | 1000 | SI8620AB-B-IS-ND | SI8620AB-B-IS | DGTL ISO 2500VRMS 2CH GP 8SOIC |  | 223 | 777 | 1.01701 | 1017.01
10 | 1000 | PIC16F1614-E/SL-ND | PIC16F1614-E/SL | IC MCU 8BIT 7KB FLASH 14SOIC |  | 864 | 136 | 0.88 | 880.00
11 | 1000 | 738-CSS0402FT10L0CT-ND | CSS0402FT10L0 | RES SHUNT, 0402, 0.01 OHM, 1%, 0 |  | 1000 | 0 | 0.112 | 112.00
12 | 1000 | 296-21208-1-ND | UA78M33CKVURG3 | IC REG LINEAR 3.3V 500MA TO252-3 |  | 1000 | 0 | 0.22475 | 224.75
13 | 1000 | 296-13998-5-ND | UA7812CKCS | IC REG LINEAR 12V 1.5A TO220-3 |  | 1000 | 0 | 0.3045 | 304.50
14 | 900 | 945-3053-2-ND | R1SX-3.33.3-R | DC DC CONVERTER 3.3V 1W |  | 900 | 0 | 2.352 | 2116.80
15 | 100 | 945-3053-1-ND | R1SX-3.33.3-R | DC DC CONVERTER 3.3V 1W |  | 100 | 0 | 2.604 | 260.40
16 | 1000 | 277-15492-ND | 5452258 | TERM BLK 3P SIDE ENT 5.08MM PCB |  | 168 | 832 | 1.11781 | 1117.81
17 | 1000 | 102-6203-ND | TB007-508-02BE | TERMINAL BLOCK, SCREW TYPE, 5.08 |  | 1000 | 0 | 0.1872 | 187.20
18 | 1000 | 2057-PH2-06-UA-ND | PH2-06-UA | CONN HEADER VERT 6POS 2.54MM |  | 1000 | 0 | 0.04836 | 48.36
19 | 2000 | 399-C0603C103M5RAC7411CT-ND | C0603C103M5RAC7411 | CAP CER 10000PF 50V X7R 0603 |  | 2000 | 0 | 0.00756 | 15.12
20 | 2000 | 732-7992-1-ND | 885012206074 | CAP CER 0.33UF 25V X7R 0603 |  | 2000 | 0 | 0.06376 | 127.52
21 | 1000 | 1276-7076-1-ND | CL10A226MO7JZNC | CAP CER 22UF 16V X5R 0603 |  | 1000 | 0 | 0.18902 | 189.02
22 | 4000 | 2019-RK73B1JTTD200GCT-ND | RK73B1JTTD200G | RES 20 OHM 2% 1/8W 0603 |  | 0 | 4000 | 0.01068 | 42.72
23 | 1000 | 2019-RK73B1JRTTD472GCT-ND | RK73B1JRTTD472G | RES 4.7 KOHM 2% 1/10W 0603 |  | 0 | 1000 | 0.01703 | 17.03
24 | 2000 | 2019-RK73B1JRTTD102GCT-ND | RK73B1JRTTD102G | RES 1 KOHM 2% 1/8W 0603 |  | 0 | 2000 | 0.01703 | 34.06
25 | 3000 | 2019-RK73B1JTTD103GCT-ND | RK73B1JTTD103G | RES 10K OHM 2% 1/10W 0603 |  | 0 | 3000 | 0.01068 | 32.04
26 | 2000 | 2019-RK73B1JTTD562GCT-ND | RK73B1JTTD562G | RES 5.6K OHM 2% 1/10W 0603 |  | 0 | 2000 | 0.01068 | 21.36
27 | 8000 | 2679-C0603X7R160-104KNPTR-ND | C0603X7R160-104KNP | CAP CER 0.1UF 16V X7R 0603 |  | 8000 | 0 | 0.00433 | 34.64
28 | 4000 | 2679-C0603X5R100-105MNETR-ND | C0603X5R100-105MNE | CAP CER 1UF 10V X5R 0603 |  | 4000 | 0 | 0.0078 | 31.20
29 | 1000 | HS407-ND | 573100D00000G | TOP MOUNT HEATSINK .4" D-PAK |  | 1000 | 0 | 1.82958 | 1829.58
30 | 800 | AE10774TR-ND | V-1100-SMD/B | HEAT SINK COPPER DPAK TO-252 |  | 0 | 800 | 0.4896 | 391.68
31 | 200 | AE10774CT-ND | V-1100-SMD/B | HEAT SINK COPPER DPAK TO-252 |  | 0 | 200 | 0.5585 | 111.70
