ceyhunkocc/EE463-TermProject/Ceyhun/Component Selection/EE463_Project.xlsx

Comment | Description | Designator | Footprint | LibRef | Quantity
CAP 100uf EKXL401ELL101MM25S |  | C1 | EKXL401ELL101MM25S | CAP 100uf EKXL401ELL101MM25S | 1
CAP 100uF 860020573008 |  | C2 | 860020573008 | CAP 100uF 860020573008 | 1
CAP 10nF |  | C3, C8 | 0603_CAP | CAP 10nF | 2
CAP 100nF |  | C4, C5, C6, C7, C9, C10, C16, C18 | 0603_CAP | CAP 100nF | 8
CAP 1uF |  | C11, C12, C13, C14 | 0603_CAP | CAP 1uF | 4
CAP 330nF |  | C15, C17 | 0603_CAP | CAP 330nF | 2
CAP 22uF |  | C19 | 0603_CAP | CAP 22uF | 1
CONN KLE3 |  | CONN1 | kle3 | CONN KLE3 | 1
CONN KLE2 |  | CONN2 | kle2 | CONN KLE2 | 1
DI S2GTR | DI, S2GTR, 400V, 2A | D1, D2, D3, D4, D5, D6, D7 | S2GTR | DI S2GTR | 7
PIC16F1614 |  | IC1 | PIC16F1613 | IC PIC16, PIC16F1614 | 1
SI8920BC |  | IC2 | SI8920BC-IP | IC ISO OP-AMP,SI8920BC | 1
SI8620AB |  | IC3 | SI8620AB | IC ISO DIG, SI8620AB | 1
BS2103F |  | IC4 | BS2103F | IC DRV, HALF-B, BS2103F | 1
UA7812CKCS |  | IC5 | UA7812CKCS | IC, LVR, UA7812CKCS | 1
UA78M33CKVURG3 |  | IC6 | UA78M33CKVURG3 | IC, LVR, UA78M33CKVURG3, 24/3V3 | 1
R1SX-3333 |  | IC7 | R1SX_3333 | IC, DC/DC, ISO, R1SX-3333 | 1
IND, 1mH, B82615B2202M001 | IND, 5mH, B82615B2202M001, 250V, 2A | IND1 | AIRD | IND, 1mH, B82615B2202M001 | 1
M? | MOS, N-CH, FDD5N550NZ, 2A | M1, M2 | FDD5N50NZ | MOS, N-CH, FDD5N550NZ | 2
H3X2 |  | P1 | H3X2 | H3X2 | 1
RES, 0.01, 0402, Shunt | RES, 0.01, 0402, Shunt, CSS0402FT10L0 | R1 | RES_0402 | RES, 0.01, 0402, Shunt | 1
RES, 10K, 0603 |  | R2, R12, R13 | 0603_RES | RES, 10K, 0603 | 3
RES, 4K7, 0603 |  | R3 | 0603_RES | RES, 4K7, 0603 | 1
RES, 1K, 0603 |  | R4, R5 | 0603_RES | RES, 1K, 0603 | 2
RES, 20, 0603 |  | R6, R7, R10, R11 | 0603_RES | RES, 20, 0603 | 4
RES, 5K6, 0603 |  | R8, R9 | 0603_RES | RES, 5K6, 0603 | 2
