ceyhunkocc/EE463-TermProject/Defne/Cost/PCM sepecs.JPG

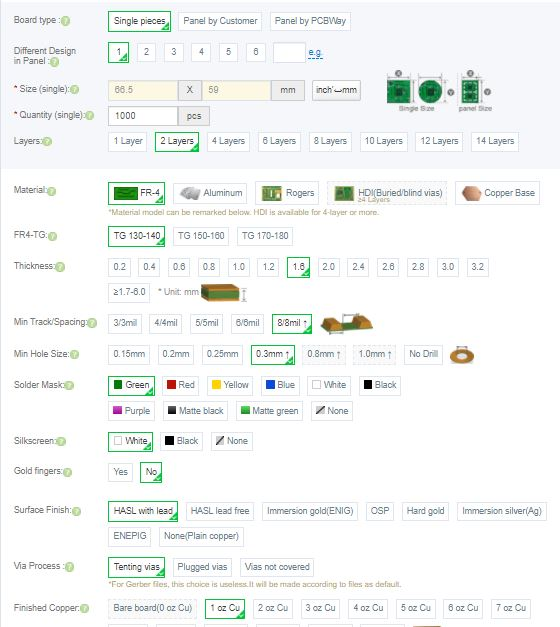
Defne/Cost/PCM sepecs.JPG
