ceyhunkocc/EE463-TermProject/(list of files, drawings)

Other design files:
EE463_Project/Battery Unit.SchDoc
EE463_Project/Conn_Unit.SchDoc
EE463_Project/Converter_Unit.SchDoc
EE463_Project/EE463_PCB.PcbDoc
EE463_Project/EE463_Project.PrjPcb
EE463_Project/EE463_Sch.SchDoc
EE463_Project/Isolation Unit.SchDoc
EE463_Project/Logic_Unit.SchDoc
EE463_Project/PcbLib1.PcbLib
EE463_Project/Power_Unit.SchDoc
EE463_Project/Rectifier_Unit.SchDoc
EE463_Project/Schlib1.SchLib
