ceyhunkocc/EE463-TermProject/(commit log)

2020-12-02 Diode rectifier simulation is done.
2020-12-02 Buck Converter Simulink model.
2020-12-06 Some changes to improve initial current and voltage are done.
2020-12-09 Buck converter model for Matlab 2018a.
2020-12-12 Control loop implied, capacitor and inductor calculation for buck converter has been done and changed.
2020-12-14 Slew rate of current arranged with a resistor to have stable output.
2020-12-21 Component selection has finished. Block schematic constructed.
2020-12-22 Schematic drawing is processing.
    [Battery Unit.SchDoc, Conn_Unit.SchDoc, Converter_Unit.SchDoc, EE463_PCB.PcbDoc, EE463_Project.PrjPcb, EE463_Sch.SchDoc, Isolation Unit.SchDoc, Logic_Unit.SchDoc]
2020-12-22 Schematic has finished, some revisions will be done.
    [Battery Unit.SchDoc, Conn_Unit.SchDoc, Converter_Unit.SchDoc, EE463_PCB.PcbDoc, EE463_Project.PrjPcb, EE463_Sch.SchDoc, Isolation Unit.SchDoc, Logic_Unit.SchDoc]
2020-12-23 Component selection and schematic parts of reports have written.
2020-12-24 Simulations for ideal case.
2020-12-24 Simulations for non-ideal case.
2020-12-25 Simulation for all circuit.
2021-01-08 Power losses calculated. Thermal analysis and heatsink selection are completed.
2021-01-09 Inductor Design Tool
    [1608928195184.xls]
2021-01-10 PCB design has been made, corrections in simulation and component selection.
    [Conn_Unit.SchDoc, Converter_Unit.SchDoc, EE463_PCB.PcbDoc, EE463_Sch.SchDoc, Isolation Unit.SchDoc, Logic_Unit.SchDoc, PcbLib1.PcbLib, Power_Unit.SchDoc]
2021-01-12 Final component selection added.
    [EE463_Project.xlsx]
2021-01-12 Component selection and schematic design corrected in report.
2021-01-12 BOM list created
    [2021-01-12T145147.xlsx, Components.xlsx]
2021-01-13 Diode and MOSFET losses are added to the report.
2021-01-13 Minor changes on PCB, new MOSFET and heatsink added, minor changes on report component selection, and pcb report added.
    [Conn_Unit.SchDoc, EE463_PCB.PcbDoc, EE463_Project.PrjPcb, Isolation Unit.SchDoc, PcbLib1.PcbLib]
2021-01-14 PCB report has been concluded.
2021-01-15 Diode-MOSFET power losses and thermal analysis are added.
2021-01-15 Inductor Design tools
    [1608928195184.xls]
2021-01-15 Cost Analysis
    [2021-01-15T045232.xlsx, BOM list.xlsx]
